jmej/MIDI2DMX/kicad/clipart/clipart.jpg

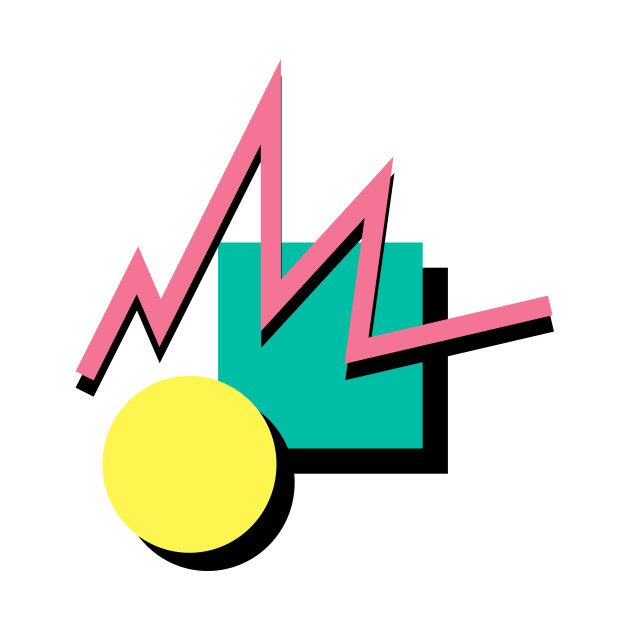
kicad/clipart/clipart.jpg
