jmej/MIDI2DMX/kicad/clipart/disco_ball.png

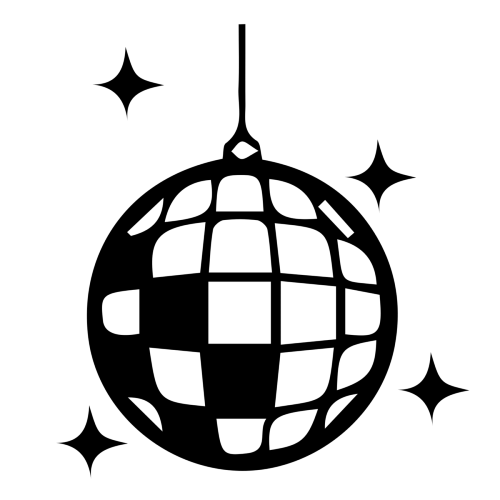
kicad/clipart/disco_ball.png
