jmej/MIDI2DMX/pcb.png

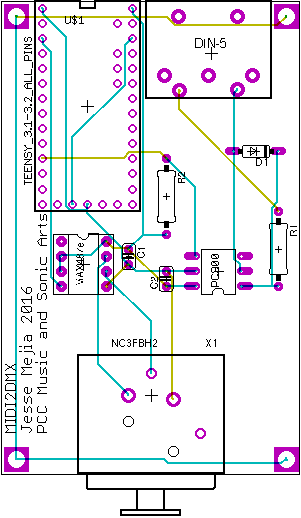
pcb.png
