jmej/MIDI2DMX/pre-render.png

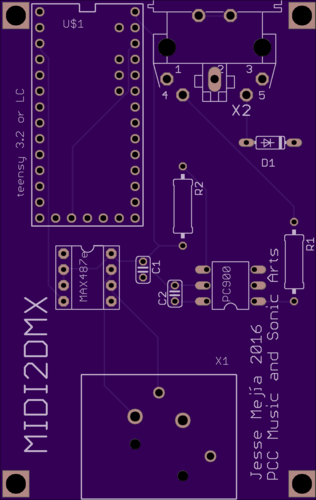
pre-render.png
