jmej/MIDI2DMX/schematic.png

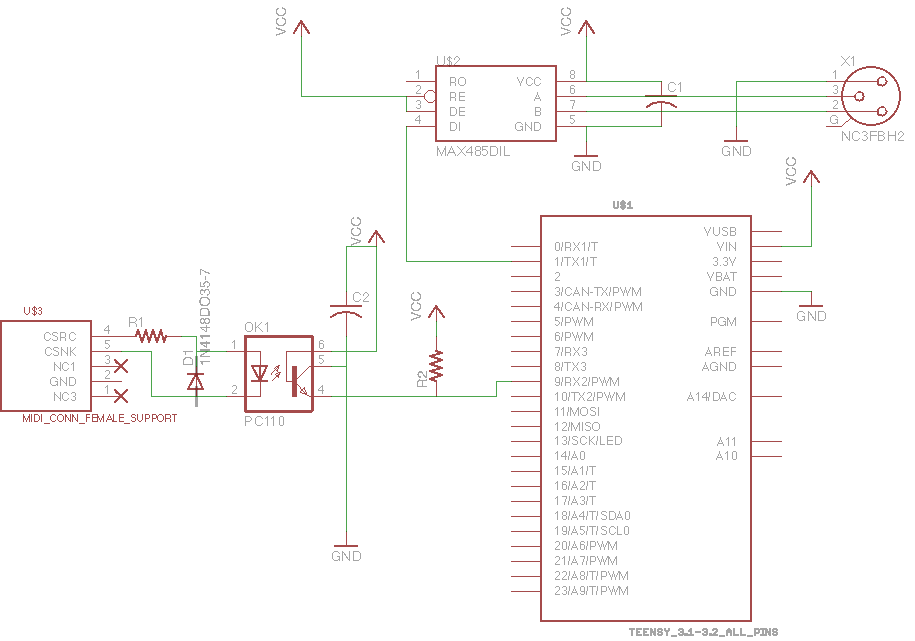
schematic.png
