jmej/MIDI2DMX/MIDI2DMX.xls

MIDI2DMX W/ ALT. XLR AND OCTOCOUPLER
Mouser # | Mfr. # | Manufacturer | Customer # | Description | RoHS | Lifecycle | Order Qty. | Price (USD) | Ext.: (USD)
700-MAX487ECPA | MAX487ECPA+ | Maxim Integrated |  | RS-422/RS-485 Interface IC RS-485/RS-422 Transceiver | RoHS Compliant |  | 1 | $3.27 | $3.27
490-SDS-50J | SDS-50J | CUI Inc. |  | Circular DIN Connectors DIN, 5Pjack, rt, throughhole, 180degreepinarrangement | RoHS Compliant |  | 1 | $1.17 | $1.17
660-MF1/4DC2700F | MF1/4DC2700F | KOA Speer | x0xheart | Metal Film Resistors - Through Hole 270ohm 1% 100PPM | RoHS Compliant |  | 1 | $0.23 | $0.23
512-1N914 | 1N914 | ON Semiconductor | 808BD | Diodes - General Purpose, Power, Switching 100V 4.0ns Diode Single Junction | RoHS Compliant |  | 1 | $0.10 | $0.10
660-MF1/4DC2200F | MF1/4DC2200F | KOA Speer | x0xheart | Metal Film Resistors - Through Hole 220ohm 1% 100PPM | RoHS Compliant |  | 1 | $0.23 | $0.23
594-K104M15X7RF53L2 | K104M15X7RF53L2 | Vishay |  | Multilayer Ceramic Capacitors MLCC - Leaded 0.1uF 50volts 20% X7R 2.5mm LS | RoHS Compliant By Exemption |  | 2 | $0.10 | $0.20
638-H11L1 | H11L1 | Everlight |  | Logic Output Optocouplers Optocouplers | RoHS Compliant |  | 1 | $0.96 | $0.96
568-NC3FBH-1 | NC3FBH1 | Neutrik |  | XLR Connectors 3C FEMALE PCB | RoHS Compliant |  | 1 | $2.78 | $2.78
