jmej/MIDI2DMX/(threads)

Thread 2 (2017-05-02):

add support for hardware midi input

jmej, 2017-05-02:
I think all this needs is this at the top of midi2dmx.ino:
`#include <MIDI.h>`

the following inside the setup method:
```
MIDI.begin(MIDI_CHANNEL_OMNI);
MIDI.setHandleControlChange(OnControlChange);
```

and this inside the loop:
`MIDI.read();
`

One potential problem:

From reading this: https://www.pjrc.com/teensy/td_libs_MIDI.html
It looks like the library is hard-coded to use the serial port on pins 0 and 1. I used pin 1 for DMX output, and the DIN for MIDI is wired to pin 9 / Serial2

@PaulStoffregen do you know an easy way around that? Probably just hack MIDI.h a little bit?

PaulStoffregen, 2017-05-02:
> I think all this needs is this at the top of midi2dmx.ino:

No, you've misunderstood.  MIDI.h is for normal serial (5 pin DIN) MIDI.  This project uses USB MIDI, not serial MIDI.

jmej, 2017-05-02:
@PaulStoffregen No - this project was designed to use both USB and Serial MIDI on a 5 pin din. Both are on the schematic and board... I'm just finally getting around to implementing it.

This issue is for 5 pin DIN. "Hardware MIDI input"

PaulStoffregen, 2017-05-02:
Oh, ok.  Then yup, use MIDI.h.

jmej, 2017-05-02:
@PaulStoffregen - right. Is there a way to specify a different serial port using MIDI.h or do I need to hack the library? The DIN is wired to Serial2, DMX is on Serial1

PaulStoffregen, 2017-05-02:
I believe newer versions allow any port to be specified.

Teensyduino might be bundling an older version.  For a while MIDI.h was broken on Teensy and the new versions added a lot of complexity, so I didn't update.  Haven't looked at this for some time...

jmej, 2017-05-02:
@PaulStoffregen I'll have to give it a shot. Do you know if there is midi clock implemented in midi.h? If that's also broken it might just be time to abandon that library imo

PaulStoffregen, 2017-05-03:
I really do not know.  I've not actually use that lib in quite some time.  When I have used it, my focus has been mostly on hardware and compatibility testing, not actually making any real MIDI project.

jmej, 2017-05-03:
@PaulStoffregen are you saying that teensyduino bundles an older version of midi.h? Or is it likely that teensyduino installs are using the same midi.h as any other arduino installation?

It looks like the current versions must work with the teensy since there are issues that reference it: ex: https://github.com/FortySevenEffects/arduino_midi_library/pull/63

sid8580, 2018-01-15:
@jmej I updated the MIDI2DMX code so hardware (5 pin DIN) MIDI now works, without impact to USB MIDI functionality.  Tested via Ableton Live over USB and Elektron Octatrack over DIN MIDI with a 3 channel DMX relay.  I added the code you suggested at the outset of this thread, but added this line above the setup code:

MIDI_CREATE_INSTANCE(HardwareSerial, Serial2, MIDI);

With MIDI.h library 4.3, works fine.  I can send you the working version to save a  minute, & I'd love to see updates to Instructables and Github to save time and add confidence the hardware MIDI port will indeed work (a potential showstopper for some of us) should less experienced builders want to try the MIDI2DMX.  It's an awesome device, thank you for the design.

jmej, 2018-01-16:
@sid8580 nice! Can you make a branch and pull request?

Re: the hardware midi port. I haven't been able to test it myself because unfortunately the chip I designed it for (the pc900) is discontinued - and I don't have any! Hopefully I'll get around to trying it soon - but I maybe should just rev the PCB to use an in production chip at this point..

What changes do you recommend to the instructables and github? I tried to be as clear as I could figure language-wise involving that chip stuff - but I know it's really confusing. I'm just not sure how to state things more clearly...

PaulStoffregen, 2018-01-16:
If you rev the PCB for a 6N138 (the best replacement), let's talk about also adding a 5 pin header + an optional USB host connector, and allowing room for Teensy 3.6 to overhang the 28 pins.  I'll get you one of those MIDI test boards soon...

jmej, 2018-01-17:
Ok - sounds interesting. Though offhand I'm not sure why USB host would be helpful - do you have an application in mind?

PaulStoffregen, 2018-01-17:
One request that comes up occasionally is interfacing USB-only MIDI products to stuff that can only receive serial.  But there are now lots of great USB-only MIDI products, like Novation Launchpad, which are great for user interfaces to projects.

Anyway, please check your email.  I have some stuff here with your name on it... just need your current mailing address.

sid8580, 2018-01-20:
@jmej - I figured out how to creach a branch/pull request, should be under Hardware MIDI for your review.
I used this octocoupler and it appears to work fine:
https://www.mouser.com/ProductDetail/638-H11L1

The Instructables page is fine, all I'd suggest is updating it to reflect the hardware MIDI updates once you feel comfortable.  It's technical stuff, can't be made fully idiot proof!

I would agree with Paul that adding USB host capability would be very helpful for some.  It's got me thinking I'd like to build something to do this (I'm guessing there are plenty of projects already out there to choose from), for my own rig.  The need does come up and it could potentially add the ability to route different MIDI signals out of my devices that have both USB and DIN MIDI (reducing the need for external MIDI I/O splitters and whatnot).

jmej, 2019-03-20:
@PaulStoffregen can I use serial1 for midi/din in and DMX out? Or is it better to stick to 2 separate ports for that?
For rev2 I'm considering using teensy pin 0 for hardware/DIN midi in (with a 6n138)  and pin 1 for DMX out (using a Max485) but not sure if the libraries will be fighting over serial1.

PaulStoffregen, 2019-03-21:
>can I use serial1 for midi/din in and DMX out?

No, because the baud rates are different.  Both pins of the same port run at the same baud rate.

>Or is it better to stick to 2 separate ports for that?

Yes

jmej, 2019-04-01:
Good to know - thanks @PaulStoffregen !

Thread 5 (2017-05-03):

rev 2 PCB

jmej, 2017-05-03:
Switch serial ports so MIDI uses the default serial interfaces. Serial1 RX == pin 0 on the 3.2 and LC

Add 2 analog pots to control an A/D envelope

Add dipswitch?

Add 3 pots + a button for programming colors

Add preset up/down buttons

jmej, 2019-03-20:
rev 2 underway

- moving from eagle to kicad
- switching to serial1
- changing out obsolete PC900 for 6N138
- not adding any physical sensors/pots/buttons for UI.. this can happen via midi instead. possibly an external controller in the future.

Thread 7 (2018-11-29):

R1 & R2 resistors not specified in schematic

fbotello, 2018-11-29:
there are two resistors used in the project (220ohm & 270ohm) that aren't specified in the schematic.

R1 is 220ohm & R2 is 270ohm.

jmej, 2019-03-20:
handling this in rev2 https://github.com/jmej/MIDI2DMX/issues/5

Closed 2019-03-20.

Thread 8 (2019-10-16):

UI / enclosure plan

jmej, 2019-10-16:
@mikeymasonic @fbotello @val-storm

We've been talking about the physical interface for these things. This is where we're at so far.

total physical ui elements: 1 knob, 1 toggle switch, 1 button, 2 RGB leds

The toggle switch can kick it into 'programming mode'
The knob can be used to cycle through hue (saturation can always stay high, value is usually handled by mid velocity)
The knob could also potentially choose a midi note# and/or dmx channel number
1 RGB led could be basically a monitor for if you don't have a light connected
the other RGB led could indicate various status things. (for saving a note preset, potentially blink patterns indicating channel numbers, etc)

The button is probably needed for various ui things.. maybe toggle switch up gets you into programming mode and you hit the button to save a color to a note number?

Everything should maybe also be programmable using documented midi commands.. so if we don't have the version with a knob.. we can program it with special midi ccs (maybe 127).

Thread 10 (2021-12-17):

Component equivalence

EduardoVC-music, 2021-12-17:
Hello there,

I'm located in Mexicn & can't get some the exact components required for this project. Is it possible to make the following substitutions?

1.  the [MAX487ECPA+](https://www.mouser.mx/ProductDetail/700-MAX487ECPA) with a [MAX485ESA+ ](https://www.mouser.mx/ProductDetail/Maxim-Integrated/MAX485ESA%2bT?qs=LHmEVA8xxfYXmvxEk%252BFtEg%3D%3D)?

2.the [H11l1](https://www.mouser.mx/ProductDetail/Everlight/H11L1?qs=d9SQH%252Bn975JqzvZ%2FywMjpw%3D%3D) with the [MOC3023S-TA1 ](https://www.mouser.mx/ProductDetail/Lite-On/MOC3023S-TA1?qs=gnaPJ2cis71c7eT2pzMF7g%3D%3D)

Apologies in advance if this doesn't make much sense. I'm a composer taking a shot at building circuits :P

jmej, 2021-12-18:
Hi @EduardoVC-music

1. The MAX485ESA+ part you linked appears SMD/SMT - so this will not fit on the board. You need a DIP (through-hole) part. For Estilo de montaje you want to see "through hole" "DIP" DIP 8" or "Dual Inline Packge".

2. This part you linked is also SMD - so same problem. But there may be more issues with this one. Do you require the hardware midi port? The optocoupler can be left off if you don't need it. If you do need it, there isn't really a substitute for the (sadly out of production) PC900 - but they can be found on ebay and other places. I don't think the H11|1 is in the bom for this project - but I assume you were looking for a replacement for the pc900. I hope this helps!

EduardoVC-music, 2021-12-20:
I was looking for a substitute indeed. Well, I'll keep searching for options. Thanks for the feedback!

jmej, 2021-12-20:
The next rev of the board will have an in-print substitution (6N138) on it - but I'm not sure when I'll be able to get to finishing that. If you want to roll your own design or build it on a breadboard you could follow the schematic outlined here for the MIDI port: https://www.pjrc.com/teensy/td_libs_MIDI.html -- and again - if you only want to use USB midi you don't need that chip at all. I've built a lot of boards without it entirely and they work great.

Thread 11 (2022-04-10):

Multiple Lights controlled independently in PD patches

PHREDD71, 2022-04-10:
I was wondering if it is possible to control two different lights daisy chained together with different addresses with the current code and PD files? I have tried getting it to work and cannot seem to figure it out.

My setup is two PAR lights connected to the MIDI2DMX board I built. I then set the first light to Address 1 and then the second light to Address 2.

Any guidance is much appreciated. I am just a hobbyist so all of this is pretty new.

sid8580, 2022-04-12:
You can definitely control multiple lights as long as they are
DMX-addressable (do you know specifically, numerically what DMX channel
they are set to receive on?), and you are sending MIDI data to the
MIDI2DMX on the right MIDI channel and CC # (can you also confirm your MIDI
output?).

If it's not working, but you know you have for example, the first par can
at 10 and the second one set to 11, you can send MIDI values via CC 10 and
11 to the MIDI2DMX and see if it works... if not, try changing the MIDI
channel (without changing the CC #) until you've run through all 16 MIDI
channels.  Off the top of my head I don't remember which channel(s) the
MIDI2DMX picks up by default but that can be set in the Arduino code.

It can be helpful to verify your MIDI equipment is sending the CC data you
think it is, too.

If it's still not working and you're 100% sure your MIDI channel, CC #'s
and DMX channel settings are in agreement, I would check your wiring.  If
you are using equipment that uses screw terminals, rather than DMX cables
(which btw aren't exactly the same as XLR cables, though shorter ones can
work) - it is easy to get the wires mixed up.

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

jmej, 2022-10-31:
Most lights take up a handful of DMX channels as well..so if you only have a few it can be easy to set the starting channel of light 1 to channel 1, and light two to channel 11... what way you have maybe 1 - 2- 3 for r-g-b of the first light and 11-12-13 for r-g-b of the second light. But it all depends on channels your lights need. Often you might have channel 7 for brightness - with the above addressing scheme your second light would respond to brightness on channel 17.

I hope this helps!

Closed 2022-10-31.

Thread 13 (2022-08-27):

CC mapping to DMX fade not working well in Ableton clip

rosscopcoltrane, 2022-08-27:
Hi there and thanks for this project, it’s really great to have a go at midi control of lights.

I’m using Ableton to control simple can fades through a Liteputer dx402a. Right now I’ve managed to get midi CC 2 to control DMX001, CC3 to control DMX002 etc etc. The lights are plugged in via Edison plugs, they aren’t addressed or DMX compatible, just plain old cans.

When trying to sequence my CC values it seems like I’m getting glitches, but on further inspection, the envelope seems to be divided into 3 or 4 zones, it’s hard to tell. This (while kind of workable), gives me the effective resolution of 30 or something, a bit steppy really. Perhaps there’s something I’ve done wrong..

Could the liteputer be causing this?

rosscopcoltrane, 2022-08-27:
DMX start address is set on Liteputer as 001 by the way.

jmej, 2022-08-31:
I think you may be in the wrong place - this is the issues thread for the midi2dmx diy project.. Im not familiar with the liteputer line of devices.. are you also using a midi2dmx board?

jmej, 2022-10-31:
Midi2DMX sends out a 7 bits of resolution - so basically there is a *2 for every value.. to translate from midi (0-127) to DMX (0-254).

Sending out higher resolution would be a nice feature - I've considered an NRPN solution - or using midi pitchbend - but for now that's the best it can do.

It sounds like you're having another issue with the liteputer and without that hardware I'm unable to test - but it should be seeing movement on every other step as your'e doing a fade.. which should look much smoother than what it sounds like you're seeing. I'm closing this issue for now - since I don't think this is an issue on the midi2DMX side of things.

Closed 2022-10-31.
