jmej/MIDI2DMX/kicad/midi2dmx.kicad_pcb

## KiCad design kicad/midi2dmx.kicad_pcb (2020-02-17)

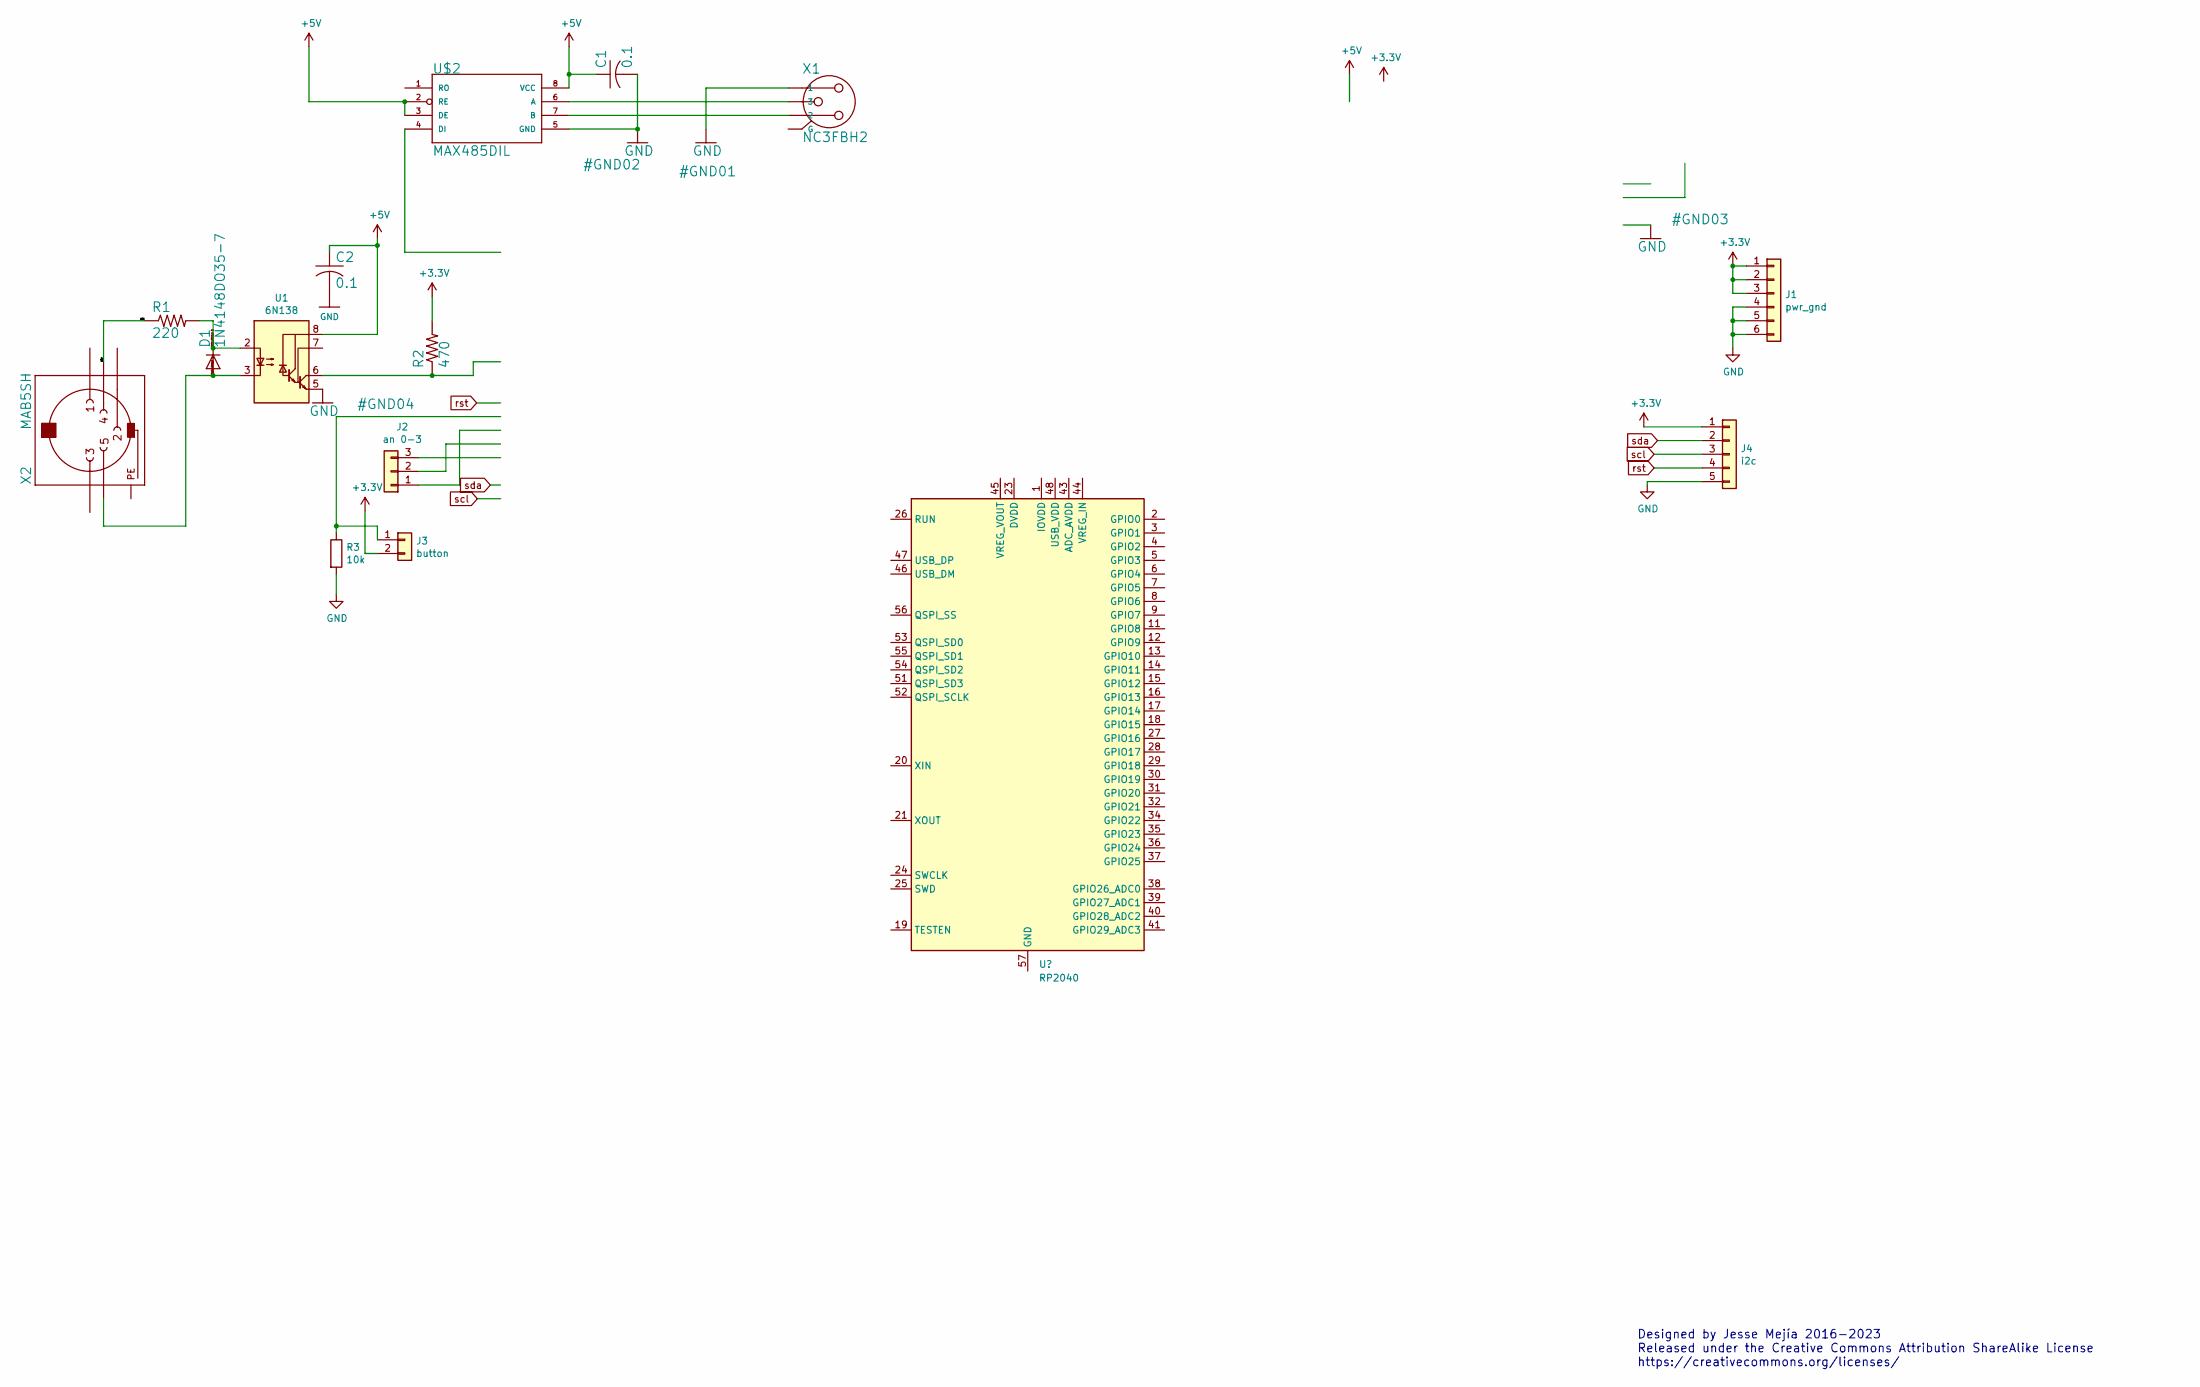
[picture p6: schematic midi2dmx.kicad_sch, Midi2DMX v2]

Parts:
C1, C2: 0.1; C025-024X044
D1: 1N4148DO35-7; DO35-7
J1: pwr_gnd; Pins_1x06_2.54mm_TH_SWD
J2: an 0-3; Pins_1x03_2.54mm_TH
J3: button; Pins_1x02_2.54mm_TH
J4: i2c; Pins_1x05_2.54mm_TH
R1: 220; R_Axial_DIN0207_L6.3mm_D2.5mm_P7.62mm_Horizontal
R2: 470; R_Axial_DIN0207_L6.3mm_D2.5mm_P7.62mm_Horizontal
R3: 10k; R_Axial_DIN0207_L6.3mm_D2.5mm_P7.62mm_Horizontal
U1: 6N138; DIP-8pin_TH
U$2: MAX485DIL; DIP-8pin_TH
X1: NC3FBH2
X2: MAB5SH

Connections:
+3V3: J1.1, J1.2, J1.3, J3.2, J4.1, R2.2; also elsewhere on the board
+5V: C1.1, C2.1, U1.8 (VCC), U$2.2 (RE), U$2.3 (DE), U$2.8 (VCC); also elsewhere on the board
/N$6: R1.1, X2.4
GND: C1.2, C2.2, J1.4, J1.5, J1.6, J4.5, R3.2, U1.5 (GND), U$2.5 (GND), X1.1; also elsewhere on the board
unnamed: D1.A, U1.3 (C2), X2.5
unnamed: D1.C, R1.2, U1.2 (C1)
unnamed 6: J2.1; also elsewhere on the board
unnamed 7: J2.2; also elsewhere on the board
unnamed 8: J2.3; also elsewhere on the board
unnamed 9: J3.1, R3.1; also elsewhere on the board
unnamed 10: R2.1, U1.6 (VO2); also elsewhere on the board
unnamed 15: U$2.4 (DI); also elsewhere on the board
unnamed: U$2.6 (A), X1.3
unnamed: U$2.7 (B), X1.2
PE: X2.PE, X2.PE@ (PE)
rst: J4.4; also elsewhere on the board
scl: J4.3; also elsewhere on the board
sda: J4.2; also elsewhere on the board

Notes on the sheet:
Designed by Jesse Mejía 2016-2023 Released under the Creative Commons Attribution ShareAlike License https://creativecommons.org/licenses/

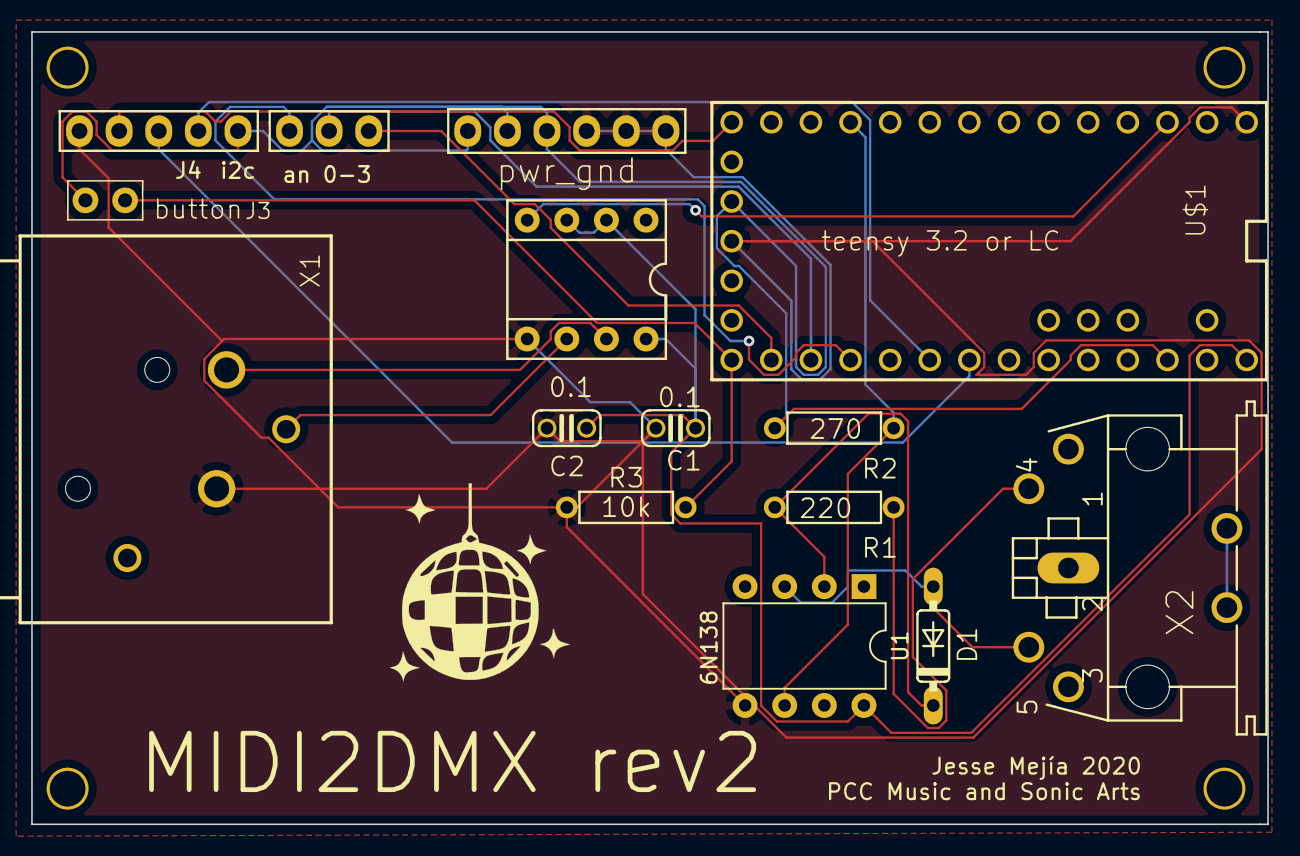
[picture p7: board midi2dmx.kicad_pcb from above]

Board: 2 copper layers, 79.2 x 50.8 mm, 19 parts (0 on the bottom side), 18 nets.

Other parts of the board:
M?: 2-56 Screw; MountingHole_2-56
M?#2, M?#3, M?#4: 2-56 Screw; MountingHole_2-56
U$1: TEENSY_3.1-3.2_ALL_PINS; TEENSY_3.0-3.2&LC_ALL_PINS

Their connections:
+3V3: U$1.3.3V, U$1.3.3V1; also elsewhere on the board
+5V: U$1.VIN; also elsewhere on the board
GND: U$1.GND, U$1.GND1; also elsewhere on the board
unnamed 6: U$1.14/A0; also elsewhere on the board
unnamed 7: U$1.15/A1; also elsewhere on the board
unnamed 8: U$1.16/A2; also elsewhere on the board
unnamed 9: U$1.13; also elsewhere on the board
unnamed 10: U$1.9; also elsewhere on the board
unnamed 15: U$1.1; also elsewhere on the board
rst: U$1.12; also elsewhere on the board
scl: U$1.19/A5; also elsewhere on the board
sda: U$1.18/A4; also elsewhere on the board
