jmej/MIDI2DMX/kicad/modified_eagle_files/midi2dmx.brd

## EAGLE design kicad/modified_eagle_files/midi2dmx.brd (2019-03-12)

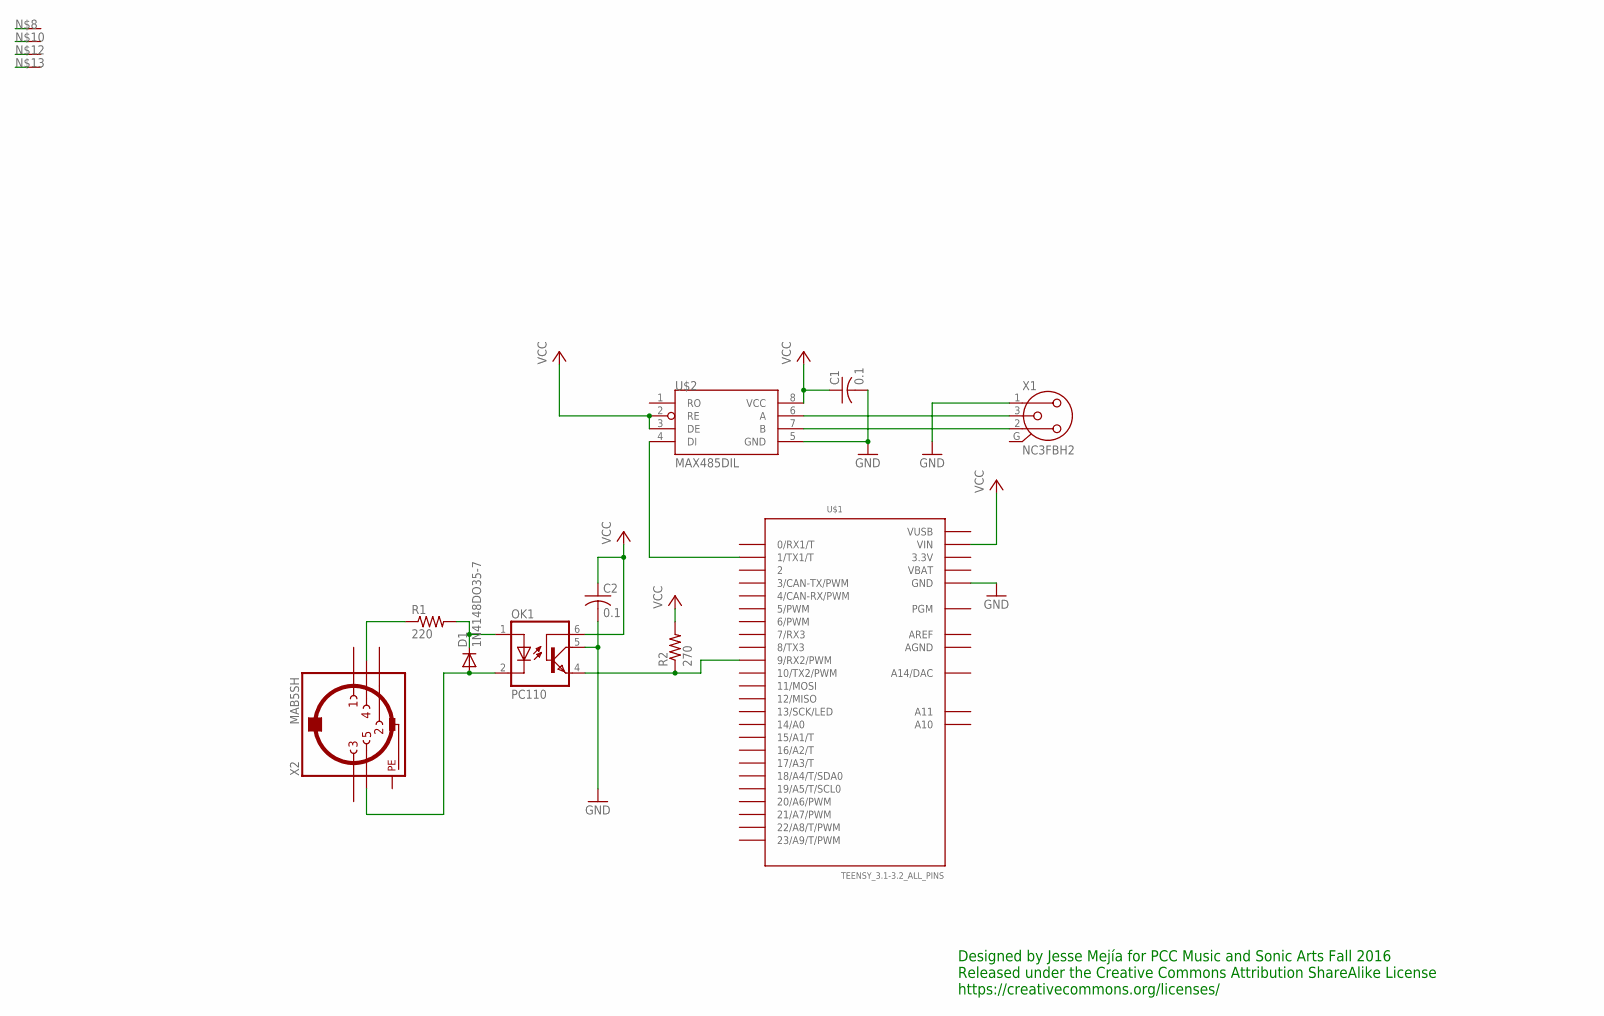
[picture p8: schematic midi2dmx.sch]

Parts:
C1, C2: 0.1; C025-024X044
D1: 1N4148DO35-7; DO35-7
OK1: PC110; DIL06
R1: 220; 0309/12
R2: 270; 0309/12
U$1: TEENSY_3.1-3.2_ALL_PINS; TEENSY_3.0-3.2&LC_ALL_PINS
U$2: MAX485DIL; DIL08
VP_0, VP_1, VP_2, VP_3: VPDEV0; VPAC0
X1: NC3FBH2
X2: MAB5SH

Connections:
3.3V: U$1.3.3V, U$1.3.3V1 (3.3V)
AGND: U$1.AGND
AREF: U$1.AREF
GND: C1.2, C2.2, OK1.5 (COL), U$1.GND, U$1.GND1 (GND), U$2.5 (GND), X1.1
unnamed: U$1.1 (1/TX1/T), U$2.4 (DI)
unnamed: U$2.6 (A), X1.3
unnamed: U$2.7 (B), X1.2
unnamed: D1.C, OK1.1 (A), R1.2
unnamed: OK1.4 (EMI), R2.1, U$1.9 (9/RX2/PWM)
unnamed: R1.1, X2.4
unnamed: D1.A, OK1.2 (C), X2.5
PE: X2.PE, X2.PE@ (PE)
VBAT: U$1.VBAT
VCC: C1.1, C2.1, OK1.6 (BAS), R2.2, U$1.VIN, U$2.2 (RE), U$2.3 (DE), U$2.8 (VCC)
VUSB: U$1.VUSB

Notes on the sheet:
Designed by Jesse Mejía for PCC Music and Sonic Arts Fall 2016 Released under the Creative Commons Attribution ShareAlike License https://creativecommons.org/licenses/

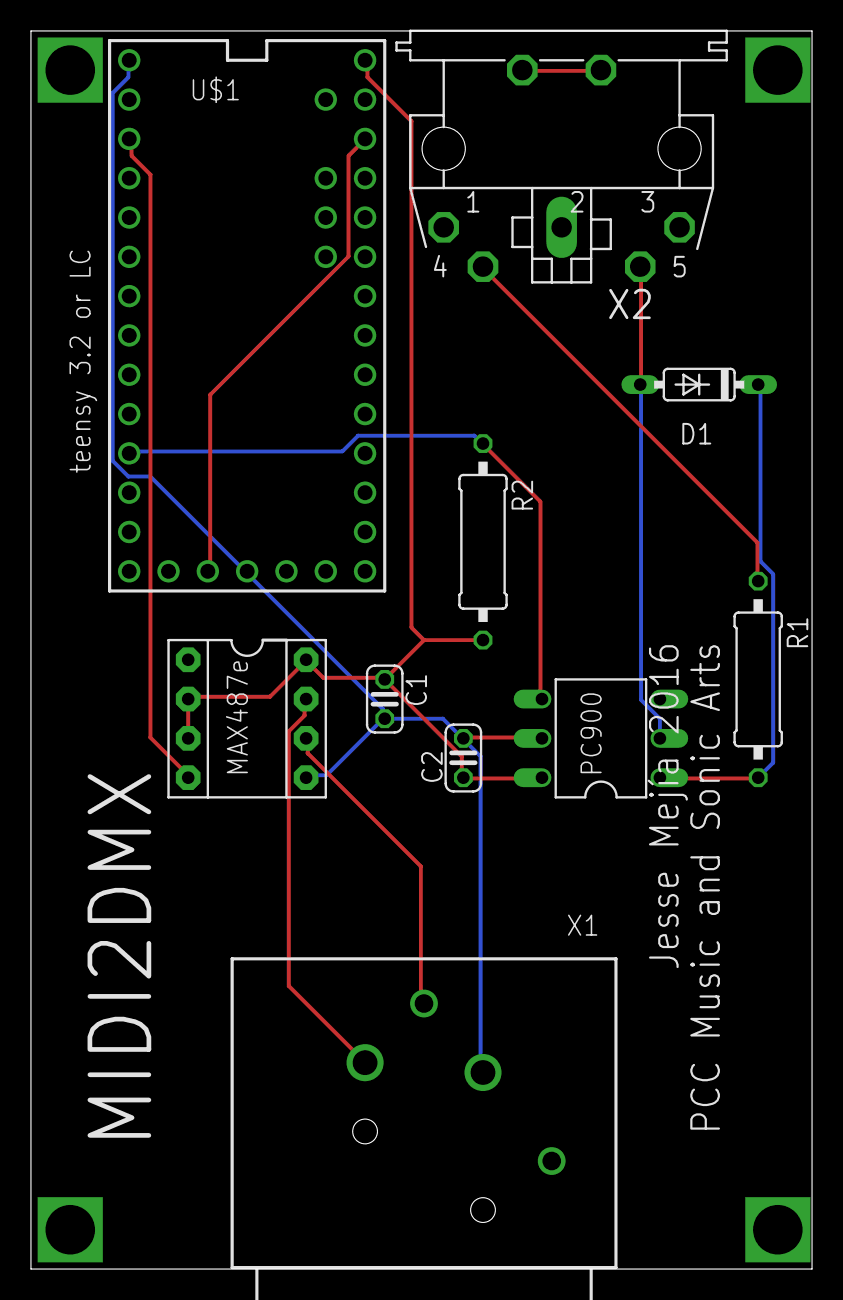
[picture p9: board midi2dmx.brd from above]

Board: 2 copper layers, 50.5 x 80.0 mm, 14 parts (0 on the bottom side), 11 nets.
