jmej/MIDI2DMX/(commit log)

2016-11-27 Minor fix in DMX code, only needed for larger # of DMX channels
    [dmx.cpp]
2019-03-12 initial conversion to kicad
    [midi2dmx-2019-03-12-10-47-38.sch, midi2dmx.brd, midi2dmx.kicad_pcb, midi2dmx.sch]
2019-03-12 rev2 schematic work
    [midi2dmx.sch]
2019-03-20 remove tiny labels
    [midi2dmx.sch]
2019-06-12 Revert "adds support for 512 dmx channels"
    This reverts commit ce72b4abcd339d6fd9302ca5fe8feac92f709eb6.
    [midi2dmx.ino]
2019-12-21 adds lasercut case plans in progress, removes broken NoteIn stuff
    [midi2dmx.ino]
2020-01-15 fixes channel update again
    [dmx.cpp, midi2dmx.ino]
2020-01-22 some board work and variable name change
2020-01-29 updates schematic for v2
    [midi2dmx.kicad_pcb, midi2dmx.sch]
2020-02-17 rev2 pcb almost ready for fab
    [midi2dmx.kicad_pcb, midi2dmx.sch]
2022-05-20 Change the device name to 'MIDI2DMX'
    Added names.c file to change the name that identifies the device in the OS
2023-03-02 swapped teensy with rp2030
    [midi2dmx.kicad_sch]
2023-03-02 schematic in progress for 2040
    [midi2dmx.kicad_sch]
2025-03-05 rp2040 port and new pcb rev wip
2025-03-17 fixes color bug that was disguised as a timing bug
    [pico_midi_dmx.ino]
2025-03-17 started pcb based on the rp2040 dev board
    [midi2dmx_2040dev.kicad_sch]
2025-03-18 pcb wip
    [midi2dmx_2040dev.kicad_sch]
2026-04-29 kicad wip
